Altair-Raphael/SomLetrando/Slides_SomLetrando.pdf

Apresentado por T2BB8 | 2026

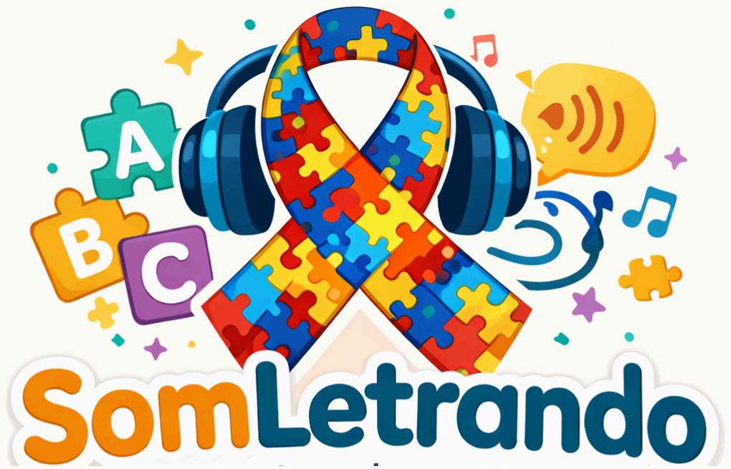
[picture p1: figure]

01

SomLetrando: mais que uma alfabetização através dos sons, um convite lúdico ao multissensorial

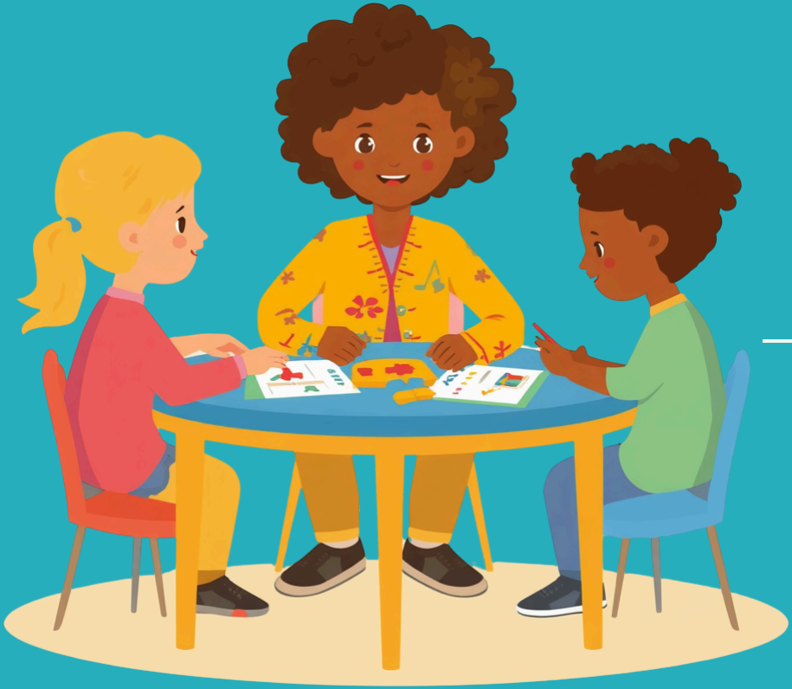
[picture p2: figure]

# Entendendo o Autismo e a Consciência Fonológica

O Transtorno do Espectro Autista (TEA) apresenta desafios únicos no processo de aprendizagem, especialmente na comunicação e linguagem.
A consciência fonológica — capacidade de associar o símbolo de cada letra ao seu respectivo som — é fundamental para o desenvolvimento da leitura e escrita. Crianças com autismo frequentemente apresentam dificuldades nessa área. Desenvolver a consciência fonológica de forma lúdica e adaptada pode transformar a comunicação dessas crianças, abrindo portas para maior autonomia e interação social.

02

## Contexto e Importância

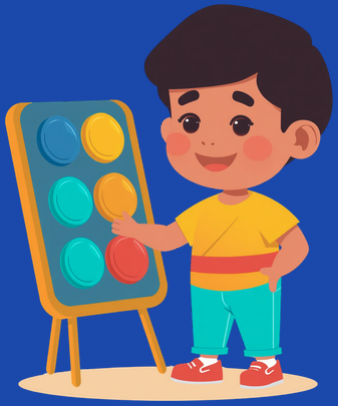
[picture p3: figure]

03

# Objetivo do SomLetrando

Desenvolver a habilidade de soletrar palavras através do reconhecimento do som de cada letra, fortalecendo a consciência fonológica.

Trabalhar a associação entre sons e letras de forma interativa, ajudando a criança a compreender a relação grafema-fonema.

Proporcionar envolvimento lúdico e educativo que motiva a criança a aprender de forma divertida e engajadora.

## Soletração Sonora

## Associação Som-Letra

## Aprendizado Lúdico

Projeto voltado a auxiliar o processo de alfabetização de crianças ( até 12 anos) no espectro autista

## Público alvo

4

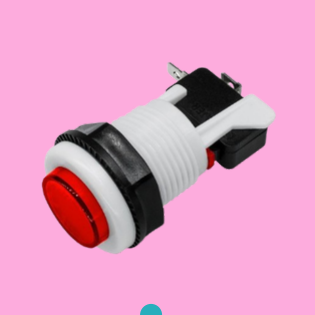
[picture p4: figure]

01

Armazenam letras
aleatórias e a letra
esperada para cada
rodada do jogo.

### 7 Botões Grandes

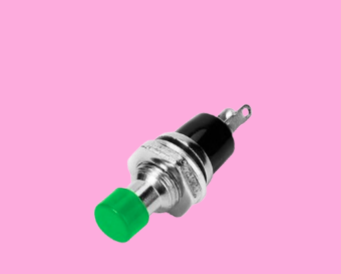
[picture p5: figure]

02

Permite múltplos
testes dos botões
até a confirmação
da jogada

### 1 Botão de Confirmação

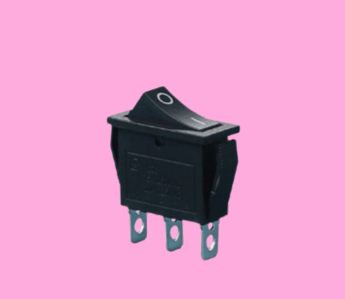
[picture p6: figure]

04

Seleção de modo
de jogo, reset do
sistema e iniciar
nova partida.

### 3 Chaves de Controle

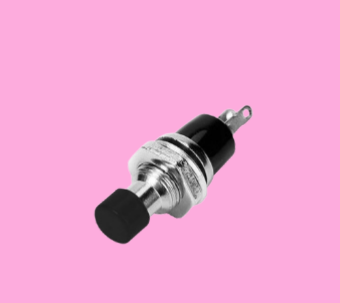
[picture p7: figure]

03

Oferece suporte e
dicas durante o
jogo para auxiliar
a criança.

### 1 Botão de Ajuda

# Visão geral do painel

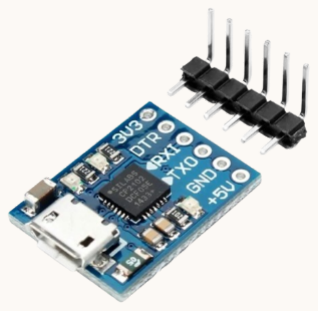
[picture p8: figure]
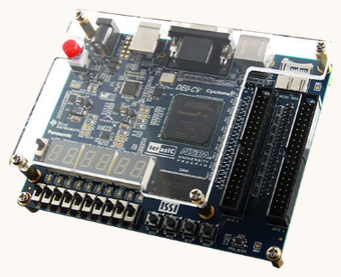
[picture p9: figure]

05

# Tecnologia FPGA e Comunicação UART

A placa FPGA é responsável pelo desenvolvimento do hardware do projeto, permitindo a programação em Verilog dos circuitos lógicos que controlam o painel didático.

## Placa FPGA

O módulo CP2102 permite a troca de dados entre os componentes do sistema, garantindo sincronização entre o painel e a interface gráfica.

## Comunicação UART

06

# Interface Gráfica e Experiência do Usuário

# Design intuitivo e engajamento

Interface completa com projetada especialmente para crianças com autismo. Ex: trocar o modo de jogo, troca a cor da tela

## Interface Intuitiva

Sistema de pontuação de erros semelhante a vidas em videogames, ajudando a criança a entender e corrigir suas respostas de forma construtiva.

## Feedback Visual

Banco com mais de 35 palavras de tamanhos variados garantindo uma experiência diferente para cada jogada

## Aleatoriedade

Experiência tátil (botões personalizados), sonora (letras e palavras em áudio) e visual (painel e interface gráfica)

## Multissensorialidade

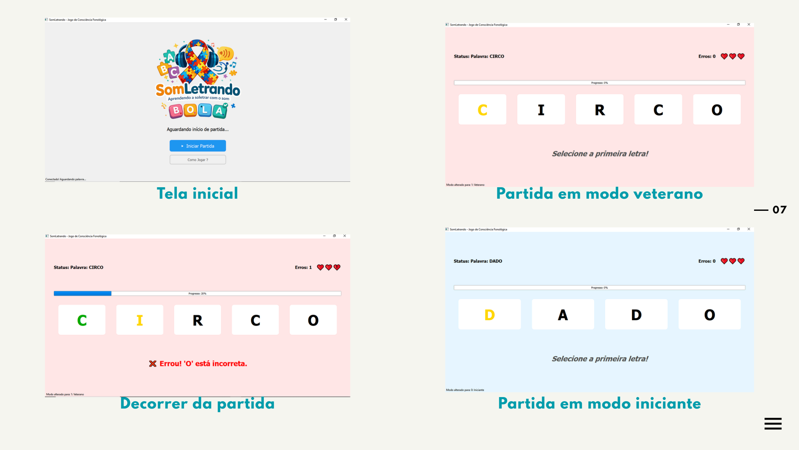
[picture p10: page 7]

Tela inicial | Partida em modo veterano
Decorrer da partida | Partida em modo iniciante

07

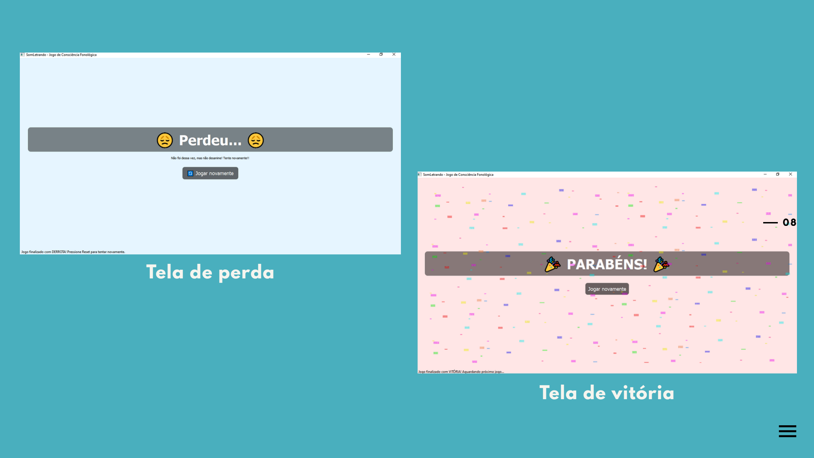
[picture p11: page 8]

# Tela de perda

# Tela de vitória

08

09

# Benefícios para Crianças com Autismo

Estimula o reconhecimento de sons e letras de forma gradual, fortalecendo habilidades
essenciais para leitura e
comunicação.

Botões grandes e coloridos facilitam a interação,
proporcionando autonomia e confiança durante o uso do jogo.

Sons de vitória e indicadores visuais reforçam acertos, enquanto o botão de ajuda oferece suporte imediato quando necessário.

Consciência Fonológica | Acessibilidade | Feedback e Suporte

10

Nome: Enzo Pimentel Lorenzon | Número USP: 14568409
Nome: Altair Raphael Alcazar Perez | Número USP: 14555666
Nome: Giovana Une Oyakawa | Número USP: 15455343

# Obrigado pela atenção!
