Altair-Raphael/SomLetrando/semana_0.2/Semana0.2_T2BB8_Relato.pdf

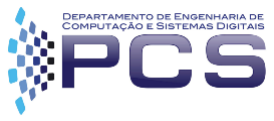
[picture p12: figure]

ESCOLA POLITÉCNICA DA UNIVERSIDADE DE SÃO PAULO Departamento de Engenharia de Computação e Sistemas Digitais

## PCS3635 – LABORATÓRIO DE PROJETO DE SISTEMAS DIGITAIS I

## Semana 0.2 – Pesquisa Refinada de Justificativa do Projeto

### Relato da Bancada B8 – Turma 2 – Prof. Antonio

Data de Emissão: 09 de março DE 2026.

Nome: Enzo Pimentel Lorenzon | Número USP: 14568409
Nome: Giovana Une Oyakawa | Número USP: 15455343

### 1 INTRODUÇÃO

O objetivo deste relatório é documentar os resultados da atividade de pesquisa refinada de justificativa do projeto extensionista de PCS3635 – Laboratório de Projeto de Sistemas Digitais I.

### 2 RELATO DA PESQUISA BIBLIOGRÁFICA

O relato da pesquisa refinada de justificativa do projeto extensionista de PCS3635 está presente na Tabela 1.

Tabela 1 – Relato da Atividade Extensionista
Relato da Atividade e de seus Resultados

Historicamente, apenas cerca de 50% de pessoas no espectro TEA alcançam um nível de domínio de linguagem suficiente para interagir com o meio externo com menores impactos negativos, os outros 50%, não adquirindo essa habilidade, não raramente acabam recorrendo a métodos não convencionais de comunicação (Ex.: autoflagelação, destruição de propriedade, agressividade no geral, etc.). [1].

Para mitigar, esses efeitos negativos, e melhorar a qualidade de vida tanto dos indivíduos no espectro, quanto das pessoas no seu entorno, é utilizada a abordagem fonológica durante a alfabetização. Na verdade, essa é uma metodologia de ensino eficiente tanto para neurotípicos, quanto atípicos[2]. Entretanto, para abranger, também, alunos não verbais, é necessário o uso de uma abordagem conhecida como Nonverbal Reading Approach (NRA)[3]. Ela, com o auxílio de sight words[4], permite que seja utilizada a voz interna do indivíduo (a mesma que ocorre ao ler textos em silêncio) ao invés de verbalizar as palavras oralmente.

Tendo isso em mente, o projeto desenvolvido na disciplina busca abordar de forma lúdica, a partir de um jogo, o desenvolvimento da consciência fonológica tendo em mente atender todos os níveis de suporte do espectro. Para isso, o equipamento terá uma tela para visualização das palavras por escrito, autofalantes para “falar” a palavra escolhida e as letras individualmente, além de botões coloridos correspondentes a cada letra para que o usuário consiga fazer sua jogada.

O espectro TEA abarca 3 níveis de suporte: nível 1 (autismo leve), nível 2 (autismo moderado) e o nível 3 (autismo severo). Em relação ao ensino, o primeiro nível possui maior facilidade de aprendizado quando há inclusão de reforços visuais, já o segundo nível tem maiores dificuldades de comunicação tanto verbal quanto não verbal, por último o terceiro nível demanda uma maior dedicação nas ferramentas de aprendizagem como uso de comunicação alternativa e sistemas multissensoriais.

O especialista no campo de neuroaprendizagem, Grandin (2021) reforça essas características de aprendizado: para crianças com TEA, a previsibilidade, a rotina e os estímulos sensoriais adequados são elementos fundamentais para a consolidação da aprendizagem na medida em que essas características reduzem a ansiedade e aumentam o foco.

Nesse sentido, o projeto se encontra bem definido, integrando múltiplos recursos sensoriais visuais (interfaces gráficas, leds), sonoros (alto falante reproduzindo letras) e táteis (personalização de textura dos botões) e estimulando a aprendizagem de todos os níveis do espectro TEA.

Contudo, vale ressaltar que o aprendizado de autistas, mesmo aqueles que pertencem a um mesmo nível, é completamente distinto entre si. Por conta disso, a mediação social através do professor, algum profissional ou pais é extremamente relevante para facilitar a decodificação simbólica e a formação de memórias linguísticas duradouras.

Assim, o projeto constitui-se como um objeto relevante até mesmo como ferramenta de uso em sala de aula pelos educadores ou em casa pelos pais, não só mediando o aprendizado como também construindo a confiança da criança e fortalecendo vínculos emocionais.

Lista de Referências (se aplicável; caso contrário, marcar como “Não Aplicável”)
1) LAZ, L. ScholarWorks Teaching Emergent Literacy Skills to Students with Autism. [s.l:
s.n.]. | Disponível | em:
<https://scholarworks.boisestate.edu/cgi/viewcontent.cgi?article=1003&context=sped_grad proj>.
2) NUNES, D. R. DE P.; WALTER, E. C. Processos de Leitura em Educandos com Autismo: um Estudo de Revisão. Revista Brasileira de Educação Especial, v. 22, n. 4, p. 619–632, dez. 2016.
3) Nonverbal | Reading. | Disponível | em:
<https://www.eiltsfamily.org/udl_at/resources/Reading/Nonverbal_reading.pdf>. | Assesso
em: 09 mar. 2026.
4) Spector, J.E. Sight Word Instruction for Students with Autism: An Evaluation of the
Evidence | Base. | J | Autism | Dev | Disord | 41, | 1411–1422 | (2011).
https://doi.org/10.1007/s10803-010-1165-x
5) Vista do NEUROAPRENDIZAGEM E ALFABETIZAÇÃO DE CRIANÇAS COM TRANSTORNO DO ESPECTRO DO AUTISMO: COMO ENSINAR AOS NÍVEIS 1, 2 E 3 DE SUPORTE NO 1o ANO DO ENSINO FUNDAMENTAL. Disponível em: <https://realizeducscientificjournal.com/index.php/rsj/pt_BR/article/view/5/4>. Acesso em: 9 mar. 2026.
6) CUGNASCA, P.S.; SILVA NETO, A.V.; MIDORIKAWA, E.T.; ARAKAKI, R.A. O Papel do Laboratório de Eletrônica Digital como Disciplina Integradora de Competências para o Desenvolvimento de Projetos de Engenharia. In: 52º Congresso Brasileiro de Educação em Engenharia (COBENGE 2024). Anais [...]. Vitória (ES), Brasil, 2024. DOI: 10.37702/2175-957X.COBENGE.2024.5074.
7) GitHub: Let’s Build from Here. 2024. Disponível em: <https://github.com/>. Acesso em: 06 fev. 2025.

### 3 AUTOAVALIAÇÃO CIRCUNSTANCIADA DA EQUIPE

A autoavaliação dos membros da pesquisa refinada de justificativa do projeto extensionista de PCS3635 é apresentada entre a Tabela 2 e a Tabela 4.

Tabela 2 – Autoavaliação Circunstanciada do Integrante 1
Nome: | Giovana Une Oyakawa
Número USP: | 15455343
Horas Trabalhadas: | 4h
Autoavaliação (0,0 a 10,0): | 8

Contribuição para a
Equipe e Justificativa (até 300 caracteres):

Houve a dedicação do tempo parcialmente para a pesquisa do público alvo e parcialmente para a pesquisa de desafios. Ao final, uma pesquisa conjunta do grupo foi feita para atualização dos componentes necessários.

Tabela 3 – Autoavaliação Circunstanciada do Integrante BBBBB
Nome: | Enzo Pimentel Lorenzon
Número USP: | 14568409
Horas Trabalhadas: | 4h
Autoavaliação (0,0 a 10,0): | 9
Contribuição para a Equipe e Justificativa (até 300 caracteres): | Trabalho de pesquisa para validar o problema a ser resolvido, bem como quais as metodologias mais adequadas para fornecer uma solução ao público alvo do projeto desenvolvido na disciplina.
