Altair-Raphael/SomLetrando/semana1/docs/PCS3635-T2BB8-Planejamento-Semana1.pdf

ESCOLA POLITÉCNICA DA UNIVERSIDADE DE SÃO PAULO Departamento de Engenharia de Computação e Sistemas Digitais

## PCS3635 – LABORATÓRIO DE PROJETO DE SISTEMAS DIGITAIS I

## PROJETO SomLetrando – AEX4

### Especificação Final da Bancada B8 – Turma 2 – Prof. Antonio Vieira

Data de Emissão: 13 de março de 2026.

Nome: Enzo Pimentel Lorenzon | Número USP: 14568409
Nome: Altair Raphael Alcazar Perez | Número USP: 14555666
Nome: Giovana Une Oyakawa | Número USP: 15455343

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
2.4.1

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
2.4.2

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
2.4.3

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
O 10
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
### 1 INTRODUÇÃO

Como tema de projeto da disciplina PCS3635 - Laboratório de Projetos de Sistemas Digitais, foi proposto a criação de soluções voltadas para a comunidade TEA (Transtorno do Espectro Autista). Inicialmente foram feitos trabalhos de pesquisa para entender melhor os desafios enfrentados e as necessidades do público-alvo. Com isso, foi possível definir escopo para o projeto: Auxílio na criação de consciência fonológico de indivíduos no espectro. Historicamente, apenas cerca de 50% de pessoas no espectro TEA alcançam um nível de domínio de linguagem suficiente para interagir com o meio externo com menores impactos negativos, os outros 50%, não adquirindo essa habilidade, não raramente acabam recorrendo a métodos não convencionais de comunicação (Ex.: autoflagelação, destruição de propriedade, agressividade no geral, etc.) [1].

Para mitigar esses efeitos negativos, e melhorar a qualidade de vida tanto dos indivíduos no espectro, quanto das pessoas no seu entorno, é utilizada a abordagem fonológica durante a alfabetização. Na verdade, essa é uma metodologia de ensino eficiente tanto para neurotípicos, quanto atípicos[2]. Entretanto, para abranger, também, alunos não verbais, é necessário o uso de uma abordagem conhecida como Nonverbal Reading Approach (NRA)[3]. Ela, com o auxílio de sight words[4], permite que seja utilizada a voz interna do indivíduo (a mesma que ocorre ao ler textos em silêncio) ao invés de verbalizar as palavras oralmente.

Tendo isso em mente, será desenvolvido um jogo de nome comercial somLetrando, com o objetivo de ensinar e praticar a associação de sons com letras para formar palavras de maneira lúdica, auxiliando no desenvolvimento da consciência fonológica. Um alto-falante externo será responsável por reproduzir o som de uma palavra qualquer contida na memória do circuito e o usuário terá à disposição um painel contendo botões de diversas cores, cada uma associada ao som de uma letra. Com isso, vence o jogo se o jogador for capaz de selecionar na ordem correta as letras que compõem a palavra escolhida a partir de seus sons.

### 2 ESPECIFICAÇÃO TÉCNICA DO PROJETO

O objetivo desta seção do documento é detalhar a especificação técnica do projeto SomLetrando.

### 2.1 CONTEXTO DE APLICAÇÃO DO PROJETO

O espectro TEA abarca 3 níveis de suporte: nível 1 (autismo leve), nível 2 (autismo moderado) e o nível 3 (autismo severo). Em relação ao ensino, o primeiro nível possui maior facilidade de aprendizado quando há inclusão de reforços visuais, já o segundo nível tem maiores dificuldades de comunicação tanto verbal quanto não verbal, por último o terceiro nível demanda uma maior dedicação nas ferramentas de aprendizagem como uso de comunicação alternativa e sistemas multissensoriais.

Para crianças com TEA, a previsibilidade, a rotina e os estímulos sensoriais adequados são elementos fundamentais para a consolidação da aprendizagem na medida em que essas características reduzem a ansiedade e aumentam o foco [5].

Nesse sentido, o projeto se encontra bem definido, integrando múltiplos recursos sensoriais visuais (interfaces gráficas, leds), sonoros (alto falante reproduzindo letras) e táteis (personalização de textura dos botões) e estimulando a aprendizagem de todos os níveis do espectro TEA, contidos na faixa etária de 2 a 12 anos. Esse grupo foi escolhido por existir uma gama de estudos voltadas a esse público mais extensa, infelizmente, o impacto que tais medidas podem ter na educação de pessoas mais velhas ainda não foi estudado com o mesmo empenho. Portanto, é possível ter maior confiabilidade do impacto dos métodos utilizados nesse projeto para o público infantil. Entretanto, nada garante que, com o acompanhamento adequado de profissionais, esse jogo não possa trazer um aumento da qualidade de vida de pessoas fora da faixa etária alvo.

Contudo, vale ressaltar que o aprendizado de autistas, mesmo aqueles que pertencem a um mesmo nível, é completamente distinto entre si. Por conta disso, a mediação social através do professor, algum profissional ou pais é extremamente relevante para facilitar a decodificação simbólica e a formação de memórias linguísticas duradouras.

Assim, o projeto constitui-se como um objeto relevante até mesmo como ferramenta de uso em sala de aula pelos educadores ou em casa pelos pais, não só mediando o aprendizado como também construindo a confiança da criança e fortalecendo vínculos emocionais.

### 2.2 OBJETIVOS DO PROJETO

Dado o contexto de aplicação do projeto para pessoas com TEA, os objetivos podem ser resumidos em:

- Auxiliar o desenvolvimento da comunicação das crianças com TEA, por meio da criação da consciência fonológica;
- Configurar adequadamente os 3 componentes principais do projeto: Placa FPGA, painel de botões e computador externo;
- Criar uma interface de usuário interativa, intuitiva e confortável, para que o foco seja única e exclusivamente o aprendizado dos fonemas e não as regras do jogo. Essa interface será dependente de um computador externo;
- Captar a atenção do público-alvo;
- Desenvolver um banco de palavras para o jogo;

Para atingir estes objetivos de forma eficaz, o projeto fará uso de recursos técnicos específicos, pensados para mitigar as barreiras de aprendizagem:
Configurar adequadamente os 3 componentes principais do projeto: Placa FPGA, painel de botões e computador externo;
- A substituição de teclados convencionais por botões do tipo arcade, criando um painel tangível, reduzirá a sobrecarga motora e sensorial. Isso possibilitará captar a atenção de crianças com desafios de motricidade fina.
- O processamento central na placa DE0-CV garantirá o controle do tempo entre cliques, recurso que é muito importante para evitar que toques acidentais registrem entradas duplicadas.
- Através da comunicação serial, o computador externo reproduzirá os fonemas armazenados no banco de palavras. Tal reprodução deve ter sincronia de forma que prenda a atenção do usuário.

Com esses objetivos e métodos, espera-se que o jogo desenvolvido seja de interesse não apenas para a disciplina e o desenvolvimento da ciência na Universidade, como também cumpra o caráter de atividade extensionista auxiliando na melhor integração de pessoas com o espectro TEA na sociedade.

### 2.3 DESCRIÇÃO DE RECURSOS E CUSTOS

a) Custos e Recursos

Os custos planejados inicialmente envolvidos no projeto estão resumidos na tabela abaixo. Essa tabela poderá variar conforme a evolução do projeto e necessidades verificadas pelo grupo.

Tabela 1 – Lista de Materiais e Custo do Projeto
Item | Quantidade | Custo Unitário | Custo Total | Referência
Placa FPGA DE0-CV | 1 | 0 | 0 | Usada do laboratório
Botão para Fliperama Arcade Push Button PBS-29 | 10 | 7,70 | 77,00 | Saravati (https://www.saravati.com.br/botao-para-fliperama-arcade-push-button-pbs-29-cor-azul.html)
Chave Gangorra Redonda KCD1-106N | 3 | 3,20 | 9,60 | Saravati (https://www.saravati.com.br/chave-gangorra-redonda-kcd1-106n-neon-azul.html)
Leds | 2 | 1,00 | 2,00 | Saravati (https://www.saravati.com.br/led-5mm-alto-brilho-bicolor-vermelho-verde.html)
Computador pessoal | 1 | 0 | 0 | Alunos
Impressão do manual de usuário (3pág cada) | 3 | 2,00/pág | 20,00 | Copiadoras
Caixa organizadora | 1 | 17,90 | 17,90 | Saravati (https://www.saravati.com.br/caixa-organizadora-pequena-n118.html)
1 kit de 40 jumpers | 1 | 7,50 | 7,50 | Robocore (https://www.robocore.net/cabo/jumpers-macho-femea-x40-unidades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)

Item | Quantidade | Custo Unitário | Custo Total | Referência
Filamento de Impressão (protótipo caixa) | 1 | 37,48 | 37,48 | 3D Lab (https://3dlab.com.br/produto/filamento-abs-premium-verde-agua/?attribute_pa_peso=500g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)
Retalhos com texturas diversas | 8 | 5,00 | 40,00 | Lojas físicas (brás, 25, etc)
Custo Total do Projeto: | | | 211,48

Após pesquisa da semana 0.2 e a conversa com o Monitor Gabriel, foram adicionados para essa especificação completa: retalhos de tecidos com texturas que irão ser colocadas por cima dos botões para auxiliar no desenvolvimento tátil dos autistas uma margem de 10% na quantidade de componentes comprados visando prever quaisquer tipos de falhas ou erros de execução do projeto. Além disso, com a implementação de dois modos de jogo, foi adicionada mais uma chave ao projeto, além de um LED que sinaliza vitória para estimular a sinalização positiva.

b) Quantidade de horas de trabalho semanais planejadas pela equipe

Para o desenvolvimento adequado do projeto dentro do tempo estipulado, o grupo pretende dedicar, além do tempo de aula, um total de 5h para cada integrante, distribuídas ao longo da semana. Sabe-se que períodos com maior necessidade de desenvolvimento, tais como a semana 4 e 5 (openlab), exigirão uma carga horária de dedicação maior caso ocorram complicações durante a elaboração do projeto.

### 2.4 DEFINIÇÃO DA ARQUITETURA DO SISTEMA

Nesta seção, são apresentadas as descrições estrutural e comportamental do sistema correspondente ao projeto SomLetrando. Essa descrição é dividida em três partes: (i.) comportamental, com a dinâmica de funcionamento do sistema, (ii.) storytelling das interações dos usuários com o sistema e (iii.) estrutural, com a identificação dos blocos funcionais e de suas partes.

### 2.4.1 Descrição da Arquitetura Comportamental


Figura 1: Fluxograma da execução do projeto
Inicialmente, o usuário deve iniciar o dispositivo e depois escolher uma palavra do banco com o modo de jogo (fácil ou difícil). Caso o usuário opte pelo modo fácil, o projeto irá reproduzir a primeira letra da palavra em áudio e permitirá o teste dos botões para que o jogador encontre o botão que presume ser o correspondente ao som que ouviu até que aperte o botão confirma. Caso acerte, o projeto faz com que o usuário tente acertar a primeira letra novamente e depois acerte a segunda letra e assim sucessivamente até completar a palavra. No caso do modo difícil, o usuário ouve a palavra por completo e depois deverá soletrar a palavra por completo, acertando os botões em sequência, mas ainda podendo utilizar os botões de confirmar a escolha e repetir a palavra. Nos dois modos, caso o jogador erre alguma letra em qualquer momento, o projeto vai para um estado de erro e reproduz em tela: “Boa tentativa, não desanime e tente novamente” e reproduz um som de perda. O usuário pode apertar o botão para repetição da letra (modo fácil) ou palavra (modo difícil) a qualquer momento e pode testar múltiplas vezes os sons das letras guardadas nos botões. Ao finalizar o modo de jogo corretamente, o jogo imprime em tela uma frase “Uhul!! Você acertou, vamos jogar mais?”, além de acender um led verde de vitória no painel de botões e reproduzir a frase em alto falante.

### 2.4.2 Storytelling da Interação entre Usuários e Sistema

O usuário principal, uma criança com TEA, senta-se diante de uma caixa com botões coloridos e uma tela à sua frente. O computador emite o som da palavra “MESA”, e a criança aperta os botões coloridos relacionados aos sons “M”, “E”, “S”, “A”, nesta ordem. A cada acerto, o sistema encoraja a continuação, até emitir uma mensagem final de vitória. No caso de erro, uma mensagem de “Tente Novamente” é exibida. Além dos botões sonoros, duas alavancas, uma para iniciar o jogo, e outra para o nível de dificuldade podem ser selecionadas pelo usuário. Por fim, dois botões auxiliares de repetir escolha e de confirmar escolha se encontram na caixa.


Figura 2: Interação entre criança e SomLetrando

### 2.4.3 Descrição da Arquitetura Estrutural

O sistema seguirá uma arquitetura simplista: Entrada de dados do usuário será feita através de botões externos conectados a placa FPGA-DE0CV, ela será responsável por receber os sinais vindos do painel de botões, ler o conteúdo da memória e retransmitir os dados para o computador externo, que os processa e replica os áudios necessários.

Tabela 2 – Descrição das Interfaces entre Blocos do Sistema
Código | Descrição da Interface
A | Painel com botões coloridos
B | Placa FPGA
C | Software do Computador
D | Interface gráfica para o usuário a ser exibida no computador


Figura 3: Diagrama de blocos - visão geral


Figura 4: Diagrama do painel de botões (A)
Nesse diagrama, os botões foram coloridos para representação de que possuem texturas distintas. Como o projeto possuirá 7 letras aleatórias a cada jogada, cada uma associada a um botão, então os botões foram nomeados de 1 a 7 (Figura 3). Além disso, também foram representados uma chave para iniciar o jogo, LED's que indicam acerto e erro do usuário, um botão auxiliar caso o usuário deseje, quantas vezes quiser, repetir a palavra objetivo e, por fim, um botão que confirma a escolha do botão com base no último botão apertado.

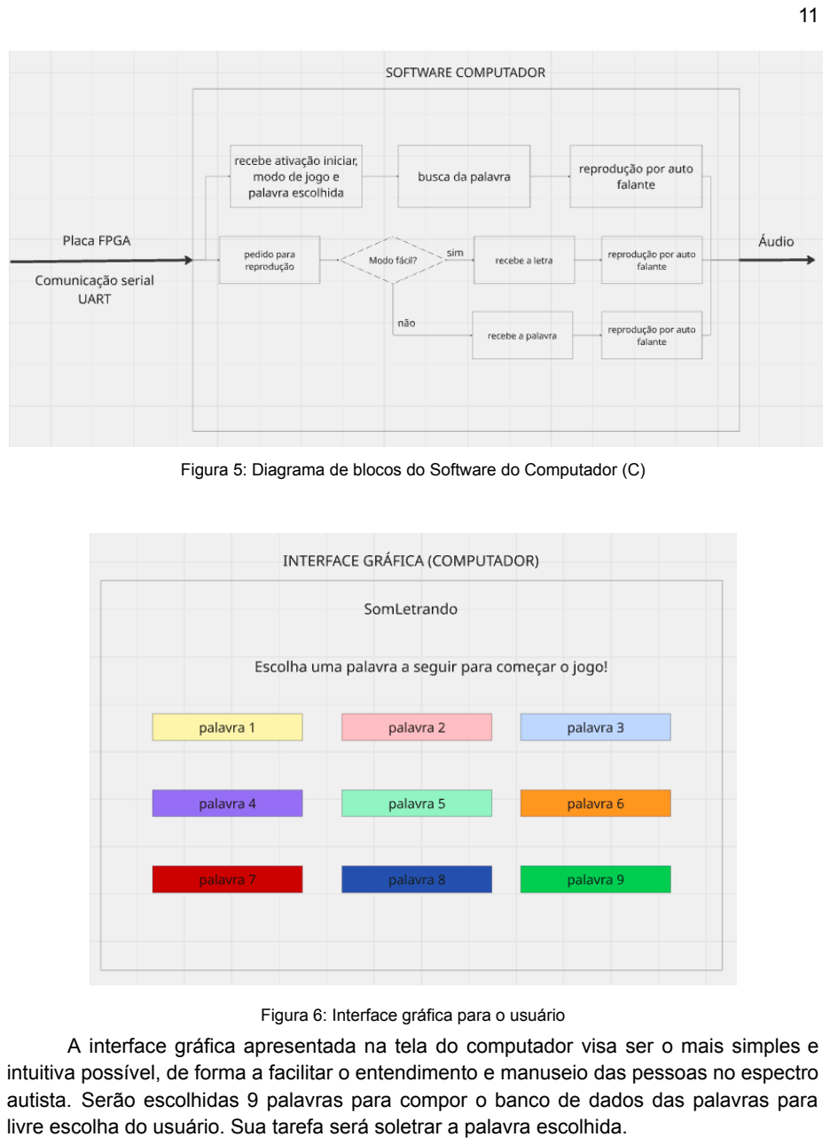
[picture p54: page 11]

Figura 5: Diagrama de blocos do Software do Computador (C)

Figura 6: Interface gráfica para o usuário
A interface gráfica apresentada na tela do computador visa ser o mais simples e intuitiva possível, de forma a facilitar o entendimento e manuseio das pessoas no espectro autista. Serão escolhidas 9 palavras para compor o banco de dados das palavras para livre escolha do usuário. Sua tarefa será soletrar a palavra escolhida.

### 2.5 ESPECIFICAÇÃO DE REQUISITOS

Nesta seção, são apresentados os requisitos funcionais e não funcionais do projeto SomLetrando. Os requisitos são especificados com base na abordagem proposta em [1], que prevê que cada requisito compreende as seguintes informações:

- Código de identificação;
- Tipo (funcional ou não funcional);
- Título;
- Descrição (com frases assertivas e sujeitos ativos);
- Prioridade;
- Estabilidade;
- Rationale (informações adicionais e justificativas);
- Requisitos associados.

Tabela 3 – Especificação do Requisito REQ-01

Código: REQ-01 | ☒Funcional | ◻ Não Funcional

Requisito: Interface Física de Entrada

Descrição: O sistema deve possuir um painel tangível composto por pelo menos 7 botões do tipo Arcade, onde cada botão será mapeado para um fonema/letra específico.

Prioridade: | ☒ Alta | ◻ Média | ◻ Baixa
Estabilidade: | ☒ Alta | ◻ Média | ◻ Baixa

Rationale: O uso de botões grandes e coloridos melhora a resposta tátil e reduz a sobrecarga sensorial em comparação com o uso de um teclado convencional de computador.

Requisitos associados: REQ-02

Tabela 4 – Especificação do Requisito REQ-02

Código: REQ-02 | ◻Funcional | ☒ Não Funcional

Requisito: Sincronia Audiovisual

Descrição: O Sistema deve garantir a emissão do estímulo sonoro da palavra com uma latência imperceptível .

Prioridade: | ☒ Alta | ◻ Média | ◻Baixa
Estabilidade: | ◻ Alta | ☒ Média | ◻ Baixa

Rationale: Estímulos sincronizados e previsíveis são essenciais para a fluidez do jogo e para evitar gerar frustração ou perda de foco do usuário

Requisitos associados: REQ-01

Tabela 5 – Especificação do Requisito REQ-03

Código: REQ-03 | ☒Funcional | ◻ Não Funcional

Requisito: Feedback Audiovisual de Validação

Descrição: O sistema deve fornecer um feedback claro, imediato e previsível para cada acerto ou erro da criança.

Prioridade: | ☒ Alta | ◻ Média | ◻Baixa
Estabilidade: | ☒ Alta | ◻ Média | ◻ Baixa

Rationale: Crianças com TEA se beneficiam da previsibilidade e de relações claras de causa e efeito. Dessa forma, o feedback imediato reforça o acerto do usuário.

Requisitos associados: REQ-01, REQ-02.

Tabela 6 – Especificação do Requisito REQ-04

Código: REQ-04 | ◻Funcional | ☒ Não Funcional

Requisito: Tolerância a toques acidentais estereotipias

Descrição: O sistema da placa FPGA deve conter uma lógica de debouncing e um tempo de delay mínimo entre leituras sucessivas do mesmo botão, evitando que tremores ou toques múltiplos acidentais registrem a mesma letra/fonema de forma repetida.

Prioridade: | ◻ Alta | ☒ Média | ◻ Baixa
Estabilidade: | ☒ Alta | ◻ Média | ◻ Baixa

Rationale: Crianças com TEA podem apresentar estereotipias motoras, dessa forma o sistema deve ser tolerante a essas características, não penalizando a criança por toques não intencionais.

Requisitos associados: REQ-01

Tabela 7 – Especificação do Requisito REQ-05

Código: REQ-05 | ☒Funcional | ◻ Não Funcional

Requisito: Seletor de dificuldade

Descrição: Permitir que o usuário defina se o sistema deverá reproduzir o som da leitura da palavra ou reproduzir o som de cada letra na sequência adequada

Prioridade: | ◻ Alta | ☒ Média | ◻ Baixa
Estabilidade: | ☒ Alta | ◻ Média | ◻ Baixa

Rationale: Permite que o usuário possa adequar o nível de dificuldade do jogo para corresponder a suas competências.

Requisitos associados: -

Tabela 8 – Especificação do Requisito REQ-06

Código: REQ-06 | ☒Funcional | ◻ Não Funcional

Requisito: Coleta e exibição de métricas de desempenho

Descrição: O sistema deve calcular métricas do desempenho (acertos) do usuário e exibi-las de forma contínua nos displays de 7 segmentos.

Prioridade: | ◻ Alta | ◻ Média | ☒ Baixa
Estabilidade: | ◻ Alta | ☒ Média | ◻ Baixa

Rationale: Coletar métricas do usuário permite que cuidadores ou terapeutas possam avaliar quantitativamente a evolução fonológica da criança.

Requisitos associados: REQ-02, REQ-05

Código: REQ-07 | ☒Funcional | ◻ Não Funcional

Requisito: Aleatorização dos botões correspondentes às letras e da escolha de palavras

Descrição: O sistema deve escolher aleatoriamente a palavra a ser soletrada em cada partida, bem como aleatorizar a atribuição das letras aos botões, ou seja, as letras não terão posições fixas no painel.

Prioridade: | ◻ Alta | ◻ Média | ☒ Baixa
Estabilidade: | ☒ Alta | ◻ Média | ◻ Baixa

Rationale: Aleatorizar o funcionamento do jogo faz com que o usuário não possa buscar “atalhos” por meio de memorização de padrões de repetição e de fato desenvolva a competência fonológica.

Requisitos associados: REQ-01, REQ-02

Código: REQ-08 | ☒Funcional | ◻ Não Funcional

Requisito: Configuração da placa FPGA

Descrição: O sistema deve ser capaz de escolher e ler o conteúdo de memória, além responder a sinais entrados por meio de botões na própria placa (Iniciar e Reset).

Prioridade: | ☒ Alta | ◻ Média | ◻ Baixa
Estabilidade: | ☒ Alta | ◻ Média | ◻ Baixa

Rationale: A placa FPGA será a fundação de todo esse sistema, ela será responsável por interpretar os sinais entrados pelo usuário, bem como enviá-los para o computador, que servirá como interface de áudio.

Requisitos associados: -

### 2.6 CRONOGRAMA DO PROJETO

O cronograma do projeto SOMLETRANDO é apresentado na Tabela 4. Nele, cada um dos requisitos especificados na seção 2.5 está alocado aos marcos das semanas de desenvolvimento do projeto. A presença de um “X” em uma célula da tabela indica que o requisito cujo código de identificação foi definido na seção 2.5 é previsto para ser implementado e demonstrado na(s) respectiva(s) semana(s) de desenvolvimento.

Tabela 4 – Cronograma do Projeto

Requisito | Semana 1 | Semana 2 | Semana 3 | Semana 4
Configuração inicial da FPGA e UART | X
Leitura de memória e sinais de | | X

Requisito | Semana 1 | Semana 2 | Semana 3 | Semana 4
controle da FPGA
Montagem estrutural do painel físico | | | X
Integração do painel com FPGA e testes para duplo clique | | | X | X
Sincronia Audiovisual e Comunicação da FPGA com o PC | | X | X
Lógica da Máquina de Estados | | X | X
Integração, testes validação dos níveis | | | | X
Lógica do feedback e aleatorização | | | X | X
Coleta e exibição de métricas nos displays | | | X | X
Impressão dos manuais do projeto | | | | X
Disponibilidade de materiais e recursos | X | X | X

### 3 SEMANA 1 DO PROJETO

O planejamento dessa semana contempla a configuração inicial da placa FPGA com para prepará-la para a integração com os outros circuitos externos necessários para o desenvolvimento desse projeto. Para isso, será utilizada a linguagem de descrição de hardware Verilog e a ferramenta Intel Quartus Prime. O projeto foca na estruturação do sistema em duas grandes unidades: o Fluxo de Dados, responsável pelo processamento e armazenamento das informações, e a Unidade de Controle, responsável pela coordenação das operações e transições de estados. O circuito será validado no ModelSim e a implementação final será feita na FPGA DE0-CV, permitindo a validação física do circuito através de testes em bancada.

### 3.1 DESCRIÇÃO FUNCIONAL DO PROJETO PARA A SEMANA

O projeto para a semana 1 é uma alteração do circuito já trabalhado na Experiência 5, caminhando para um circuito capaz de ler aleatoriamente uma ROM contendo uma palavra. A palavra será composta por até endereços de 4 bits cada, a serem enviados para decodificação no computador por meio de um protocolo de comunicação ainda não definido pelo grupo. O funcionamento do sistema obedece às seguintes especificações técnicas:

- Interface e Interação: O jogo é iniciado através do sinal jogar. O usuário deve inserir a sequência correta através dos botões (botões), sendo que cada acionamento ocorre obrigatoriamente após pressionar o botão de confirmação de jogada, registrando-a e comparado imediatamente com o conteúdo da memória ROM interna. Qualquer partida pode ser interrompida a partir da ativação do sinal de reset.
- Modos de Operação: O sistema permite a seleção de dois modos distintos: Em um dos modos, a palavra inteira é enviada para o computador externo e é lida por ele de uma vez. Já no outro, as letras que compõem a palavra são enviadas sequencialmente, na ordem correta, toda vez que o usuário acertar a letra anterior.
- Progressão: O jogo não fará, propositalmente a escolha de palavras mais ou menos difíceis, a ideia é que todas sigam uma complexidade uniforme e o tamanho do desafio seja selecionado pelos modos de operação.
- Condições de Derrota: O ciclo é interrompido, ativando o sinal pedido, caso o usuário insira um dado incorreto e aperte o botão de confirmar.
- Feedback e Depuração: Além dos sinais de estado final (ganhou, perdeu, pronto), o projeto inclui sinais de depuração (db_contagem, db_memoria, db_estado) mapeados para displays de sete segmentos, permitindo a visualização em tempo real do estado da Unidade de Controle e do progresso do usuário na sequência.

### 3.2 DETALHAMENTO DO PROJETO LÓGICO DO HARDWARE PROGRAMÁVEL

### 3.2.1 Projeto do Fluxo de Dados

Em relação ao fluxo de dados da experiência 5, foram adicionadas 4 blocos de memória ROM síncronos, um multiplexador 4x1, além do sinal de entrada confirmar, que é conectado diretamente no edge_detector, para garantir que uma nova jogada seja identificada somente por esse sinal, e não mais por qualquer alteração nas chaves de jogada do usuário. Também foi adicionado o sinal de entrada: confirmar.


Figura 1: Fluxo de dados (RTL Viewer)

### 3.2.2 Projeto da Unidade de Controle

Não foram feitas alterações na unidade de controle em relação ao projeto base da experiência 5. Dessa forma, tanto os estados quanto a lógica de transição entre eles continuam as mesmas.

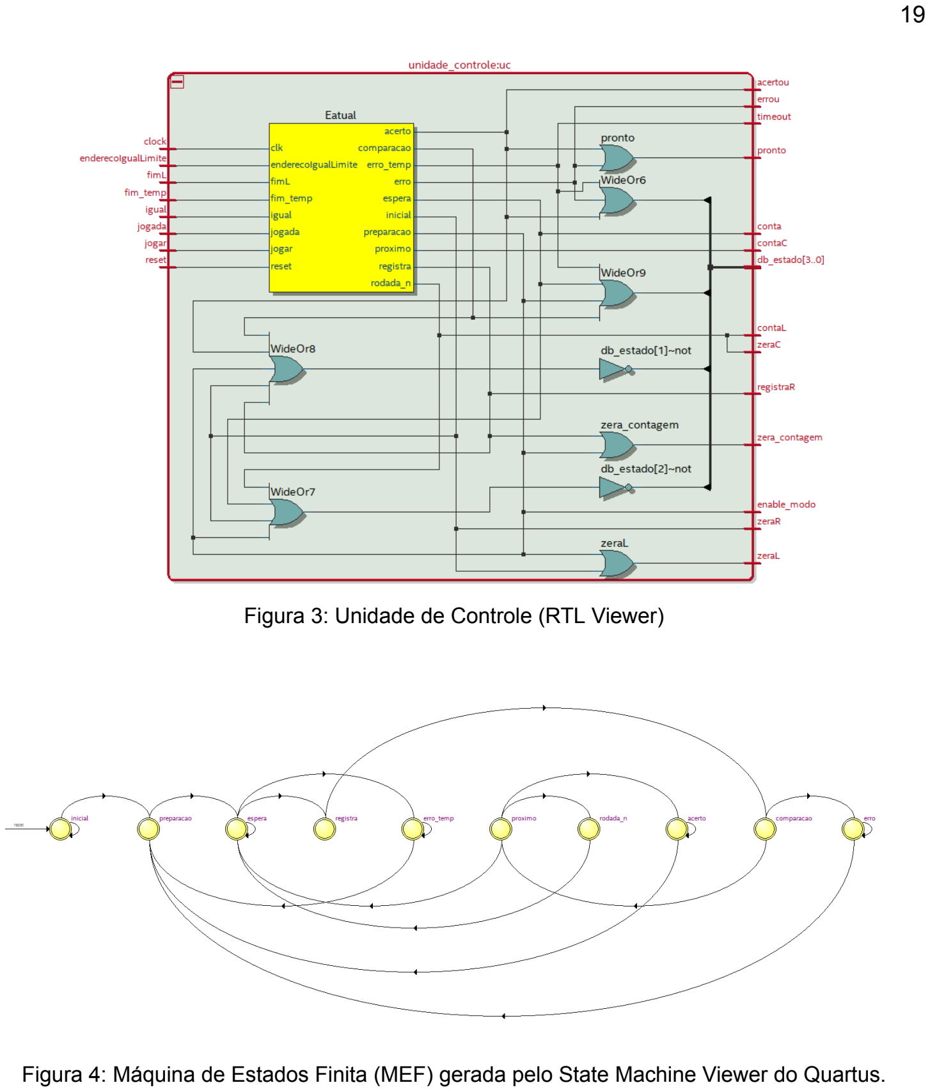
[picture p55: page 19]

Figura 3: Unidade de Controle (RTL Viewer)

Figura 4: Máquina de Estados Finita (MEF) gerada pelo State Machine Viewer do Quartus.

### 3.2.3 Projeto do Sistema Digital Programável

Foi adicionado o sinal externo ¨confirmar¨ que corresponderá ao botão acionado pelo usuário para enviar sua jogada ao registrador.


Figura 6: Diagrama de blocos do top level gerado pelo RTLViewer

### 3.3 PLANO DE TESTES DO HARDWARE PROGRAMÁVEL E SIMULAÇÕES

Como grande parte da experiência 5 foi reaproveitada para esse projeto e o objeto de testes desta semana será a aleatorização do circuito, não faz sentido a criação de testbenches para verificar o funcionamento do circuito, uma vez que isso já foi validado anteriormente. Com isso, serão feitos os testes para mostrar esse comportamento aleatório de seleção da ROM do circuito, bem como o funcionamento do ¨confirmador¨ de jogadas.

### 3.3.1 CENÁRIO DE TESTE 1 – ALEATORIZAÇÃO DE ESCOLHA DA ROM

Caso de teste para demonstrar a escolha aleatória da memória ROM baseada no momento em que o usuário aperta o botão de iniciar.

Tabela 2 – Descrição e Resultados Simulados do Cenário de Teste 1

Test e | Sinais de entrada | Modo | Resultado Esperado | Resultado Observado
reset | iniciar | chaves
C.I | 0 | 0 | 0000 | | - | Ok
1 | 1 | - | - | 1 | - | Ok

2 | 0 | - | - | 1 | - | Ok
3 | - | 1 | - | 1 | saída db_iniciar ativada | Ok
4 | - | 0 | - | - | seletor_rom_out = 11 | Ok
5 | 1 | 0 | - | - | seletor_rom_out = 00 | Ok
6 | - | 1 | - | 1 | saída db_iniciar ativada | Ok
7 | | | | | seletor_rom_out = 10 | Ok


Figura 7: Cursor posicionado indicado mostrando seleção de memória da primeira partida (11) e da segunda (10).

Como é possível observar, essa simulação valida a aleatoriedade da escolha da memória ao início de cada partida. Apenas reforçando, os valores de preenchimento da tabela de testes se referem exclusivamente a essa simulação executada, realizando ela com os mesmos sinais de entrada e na mesma sequência, nada garante que a saída será idêntica a essa.

3.3.2 CENÁRIO DE TESTE 2 - VALIDAÇÃO DO SINAL CONFIRMA AO EXECUTAR JOGADAS

A entrada será alterada por meio das chaves, e após alguns ciclos de clock será ativado o sinal confirmar. Com isso, espera-se que ao final da simulação o sistema tenha registrado a
jogada somente após o sinal de confirmação.
Test e | Sinais de entrada | confirmar | Resultado Esperado | Resultado Observado
reset | iniciar | chaves
C.I | 0 | 0 | 0000 | 0 | - | Ok
1 | 1 | - | - | - | - | Ok
2 | 0 | - | - | - | - | Ok
3 | - | 1 | - | - | saída db_iniciar ativada | Ok
4 | - | 0 | 0010 | - | jogada_reg_out = 0000 | Ok
5 | 1 | 0 | 0000 | - | jogada_reg_out = 0000 | Ok
6 | - | 0 | 0010 | - | jogada_reg_out = 0000 | Ok
7 | - | - | - | 1 | jogada_reg_out = 0010 | Ok


Figura 8: Forma de onda mostrando o registro da jogada somente após o sinal de confirmar

Como mostrado, o sinal de confirmar de fato cumpre com o comportamento especificado no projeto.

3.4 PROTOTIPAÇÃO DE PROJETo
Continua seguindo as mesmas instruções de montagem que as já presentes no planejamento/relato da experiência 5. A única alteração está no pin planner, onde o botão correspondente ao sinal de confirmar foi alocado para o pino PIN_M6.

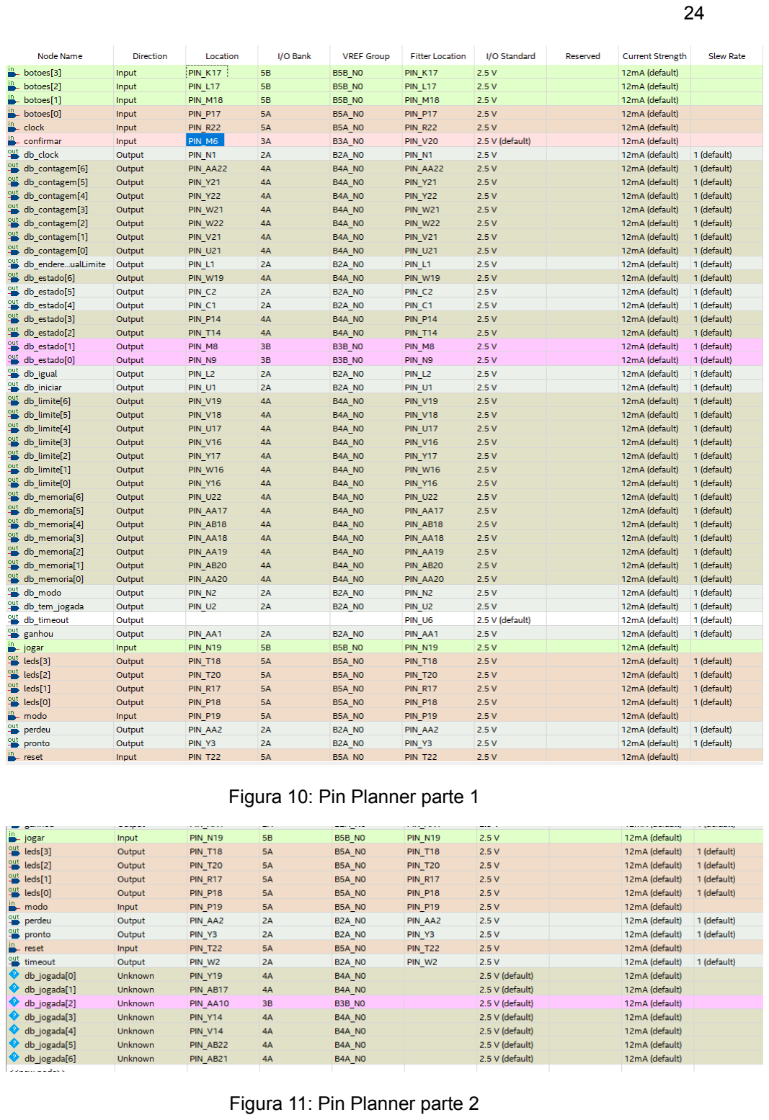
[picture p56: page 24]

Figura 10: Pin Planner parte 1

Figura 11: Pin Planner parte 2

### 4 CONCLUSÕES DO PROJETO

Ao fim das aulas extensionistas (AEX 1 a 4), além das semanas 0.1 e 0.2, foi possível adquirir uma bagagem teórica extremamente importante para identificar problemas e buscar eventuais soluções voltadas à comunidade TEA. Com isso foi definido que o objetivo do projeto desenvolvido nesta disciplina será o auxílio à alfabetização de crianças no espectro autista, uma vez que isso representa um aspecto fundamental na busca desse público por independência e grande melhoria de qualidade de vida.

Durante a elaboração desta especificação final, o principal desafio foi de traduzir necessidades clínicas e pedagógicas, como a previsibilidade, a tolerância ao erro e a adaptação sensorial, em requisitos técnicos rigorosos de engenharia. A adoção de uma arquitetura modular, que divide as responsabilidades do hardware tangível (FPGA e Painel) e da interface audiovisual do software (Computador) demonstrou ser a solução mais robusta para lidar com as características do Transtorno do Espectro Autista.
Como perspetiva de trabalhos futuros e próximos passos para as semanas de OpenLab, iremos iniciar a implementação do cronograma. O desenvolvimento irá se iniciar pela consolidação da comunicação UART entre a FPGA e o computador, avançando progressivamente para a lógica sequencial dos modos de jogo e montagem física do painel. A expectativa é que, com este planejamento delineado, o protótipo do SomLetrando chegue à Feira de Projetos como uma ferramenta assistiva funcional, validada e com elevado potencial de impacto social.

Para a semana 1 o planejamento executado sofreu com graves problemas de gestão de tempo, tendo sua qualidade final sido prejudicada por conta disso. Tais inconsistências e incompletudes serão corrigidas no relato da semana 1.

### 5 REFERÊNCIAS BIBLIOGRÁFICAS

[1] LAZ, L. ScholarWorks Teaching Emergent Literacy Skills to Students with Autism. [s.l: s.n.].
Disponível | | | | | em:
<https://scholarworks.boisestate.edu/cgi/viewcontent.cgi?article=1003&context=sped_gradproj >.
[2] NUNES, D. R. DE P.; WALTER, E. C. Processos de Leitura em Educandos com Autismo: um Estudo de Revisão. Revista Brasileira de Educação Especial, v. 22, n. 4, p. 619–632, dez. 2016.
[3] Nonverbal | | Reading. | Disponível | | em:
<https://www.eiltsfamily.org/udl_at/resources/Reading/Nonverbal_reading.pdf>. Acesso em: 09 mar. 2026.
[4] Spector, J.E. Sight Word Instruction for Students with Autism: An Evaluation of the Evidence Base. J Autism Dev Disord 41, 1411–1422 (2011). https://doi.org/10.1007/s10803-010-1165-x
[5] Vista do NEUROAPRENDIZAGEM E ALFABETIZAÇÃO DE CRIANÇAS COM TRANSTORNO DO ESPECTRO DO AUTISMO: COMO ENSINAR AOS NÍVEIS 1, 2 E 3 DE SUPORTE NO 1o
ANO | DO | ENSINO | FUNDAMENTAL. | Disponível | em:
<https://realizeducscientificjournal.com/index.php/rsj/pt_BR/article/view/5/4>. Acesso em: 9 mar. 2026.
[6]
[7] OBERG, R.; PROBASCO, L.; ERICSSON, M.; Applying Requirements Management with Use Cases. Rational Software Corporation. Technical Paper TP505 (Version 1.4), 2001.
[8] BRITES, L. Métodos de alfabetização: qual o mais adequado às crianças autistas? -
Instituto | NeuroSaber. | Disponível | em:
<https://institutoneurosaber.com.br/artigos/metodos-de-alfabetizacao-qual-o-mais-adequado-criancas-autistas/>.
[9] ALMEIDA, Izabel Cristina Araujo. Alfabetização de alunos com transtorno do espectro autista (TEA) : concepções e práticas dos professores. 2019. 147 f. Dissertação (Mestrado Acadêmico em Educação) - Universidade Estadual de Feira de Santana, Feira de Santana, 2019.
[10] BRITES, L. Consciência Fonológica em Crianças com Autismo - Instituto
NeuroSaber. | | | Disponível | | em:

<https://institutoneurosaber.com.br/artigos/consciencia-fonologica-no-tea/>.

3.1 DESCRIÇÃO FUNCIONAL DO PROJETO PARA A SEMANA (https://docs.google.com/document/d/1Y7dTLVjswokQQUY5VUKACERoD0E-Ydqh/edit#heading=h.tq2sh9ddmc5l)

3.2 DETALHAMENTO DO PROJETO LÓGICO DO HARDWARE PROGRAMÁVEL (https://docs.google.com/document/d/1Y7dTLVjswokQQUY5VUKACERoD0E-Ydqh/edit#heading=h.acydlzslnpj1)

3.2.1 PROJETO DO FLUXO DE DADOS (https://docs.google.com/document/d/1Y7dTLVjswokQQUY5VUKACERoD0E-Ydqh/edit#heading=h.t0n6ie1offel)

3.2.2 PROJETO DA UNIDADE DE CONTROLE (https://docs.google.com/document/d/1Y7dTLVjswokQQUY5VUKACERoD0E-Ydqh/edit#heading=h.8l4njym28dr4)

3.2.3 PROJETO DO SISTEMA DIGITAL PROGRAMÁVEL | 11 (https://docs.google.com/document/d/1Y7dTLVjswokQQUY5VUKACERoD0E-Ydqh/edit#heading=h.6rqmjnyx58eu)
3.3 PLANO DE TESTES DO HARDWARE PROGRAMÁVEL E SIMULAÇÕES | 11 (https://docs.google.com/document/d/1Y7dTLVjswokQQUY5VUKACERoD0E-Ydqh/edit#heading=h.j7ss6yr314t5)
3.4 DETALHAMENTO DO PROJETO DE SOFTWARE | 12 (https://docs.google.com/document/d/1Y7dTLVjswokQQUY5VUKACERoD0E-Ydqh/edit#heading=h.orpzzea0p65m)
3.4.1 DESCRIÇÃO DA ARQUITETURA DE SOFTWARE | 12 (https://docs.google.com/document/d/1Y7dTLVjswokQQUY5VUKACERoD0E-Ydqh/edit#heading=h.ljcytuhu5ket)
3.4.2 DETALHAMENTO DO PROJETO DE SOFTWARE | 12 (https://docs.google.com/document/d/1Y7dTLVjswokQQUY5VUKACERoD0E-Ydqh/edit#heading=h.ja6b128entfz)
3.5 PLANO DE TESTES DO SOFTWARE | 12 (https://docs.google.com/document/d/1Y7dTLVjswokQQUY5VUKACERoD0E-Ydqh/edit#heading=h.4if59tt559wt)
3.5.1 CENÁRIO DE TESTE X – <OBJETIVO SUCINTO DO CENÁRIO> | 12 (https://docs.google.com/document/d/1Y7dTLVjswokQQUY5VUKACERoD0E-Ydqh/edit#heading=h.75dk5f3aob5u)
3.6 INTEGRAÇÃO ENTRE HARDWARE PROGRAMÁVEL E SOFTWARE | 13 (https://docs.google.com/document/d/1Y7dTLVjswokQQUY5VUKACERoD0E-Ydqh/edit#heading=h.h963ql59e5hq)
3.7 PROTOTIPAÇÃO DO PROJETO | 13 (https://docs.google.com/document/d/1Y7dTLVjswokQQUY5VUKACERoD0E-Ydqh/edit#heading=h.3qikcbrj5d56)
3.8 IMPLANTAÇÃO DO PROJETO | 14 (https://docs.google.com/document/d/1Y7dTLVjswokQQUY5VUKACERoD0E-Ydqh/edit#heading=h.wzvezgyjmn7c)
3.8.1 PINAGEM DA PLACA FPGA | 14 (https://docs.google.com/document/d/1Y7dTLVjswokQQUY5VUKACERoD0E-Ydqh/edit#heading=h.kp4j2b99jtca)
3.8.2 ESTRATÉGIA DE MONTAGEM | 14 (https://docs.google.com/document/d/1Y7dTLVjswokQQUY5VUKACERoD0E-Ydqh/edit#heading=h.pug9bokftyjz)
3.8.3 ESTRATÉGIA DE DEPURAÇÃO | 14 (https://docs.google.com/document/d/1Y7dTLVjswokQQUY5VUKACERoD0E-Ydqh/edit#heading=h.e8z4qmt07iz2)
3.8.4 EXECUÇÃO PRÁTICA DO CENÁRIO DE TESTE X – <OBJETIVO SUCINTO DO CENÁRIO> | 15 (https://docs.google.com/document/d/1Y7dTLVjswokQQUY5VUKACERoD0E-Ydqh/edit#heading=h.3lr66zbkox0k)

3.9 CONCLUSÃO DA SEMANA (https://docs.google.com/document/d/1Y7dTLVjswokQQUY5VUKACERoD0E-Ydqh/edit#heading=h.1xnt67tdaqge)
