Altair-Raphael/SomLetrando/Versão Final/hardware/src/control/SomLetrando.v

	module SomLetrando (
		 //Inputs
		 input        clock,
		 input        reset_entrada,
		 input        jogar,
		 input        confirmar,
		 input        ajuda,
		 input        modo,
		 input  [6:0] botoes,
		 //Outputs
		 output       ganhou,
		 output       perdeu,
		 output       pronto,
		 output [6:0] leds,
		 //Outputs seriais
		 output       saida_serial,
		 output       pronto_serial,

		 //Depuracao leds
		 output       db_igual,
		 output       db_clock,
		 output       db_iniciar,
		 output       db_tem_jogada,
		 output       db_modo, 
		 output 		  db_confirmar,
		 //Depuracao displays
		 output [6:0] db_endereco_letra,
		 output [6:0] db_rom_escolhida,
		 output [6:0] db_letra_more,
		 output [6:0] db_letra_less,
		 output [6:0] db_contagem_erros,
		 output [6:0] db_estado,
		 // Depuracao serial
		 output       db_tick_serial,
		 output       db_saida_serial
	);

	//  Wires
		 wire zera_contador_wire;
		 wire zera_registrador_wire;
		 wire zeraSeletor_wire;

		 wire igual_wire;
		 wire registraR_wire;
		 wire jogada_wire;
		 wire fim_palavra_wire;
		 wire limite_erros_wire;
		 wire conta_erro_wire;
		 wire incrementa_endereco_wire;
		 wire load_end_inicial_wire;
		 wire enable_rom_wire;
		 wire enable_modo_wire;
		 wire enable_palavra_wire;
		 wire modo_wire;
		 wire zera_contador_erros_wire;
		 wire evento_reset_serial_wire;
		 wire evento_jogar_serial_wire;
		 wire evento_modo_serial_wire;
		 wire evento_erro_serial_wire;

		 wire start_tx_wire;
		 wire start_tx_ack_wire;
		 wire tx_done_inicial_wire;
		 wire start_tx_aux_req_wire;
		 wire start_tx_aux_ack_wire;
		 wire start_tx_mux_wire;
		 wire start_tx_inicial_req_wire;
		 wire start_tx_aux_req_aceito_wire;
		 wire tx_ready_wire;
		 reg  tx_busy_wire;

		 wire [3:0] estado_wire;
		 wire [3:0] db_endereco_letra_wire;
		 wire [3:0] db_rom_escolhida_wire;
		 wire [6:0] jogadafeita_wire;
		 wire [3:0] db_contagem_erros_wire;

		 wire [6:0] db_letra_wire; //letra em ascii completa a ser enviada serial
		 wire [6:0] tx_data_aux_wire;
		 wire [6:0] tx_data_mux_wire;
		 wire [6:0] jogada_parcial_decodificada_wire;
		 wire [6:0] letra_atual_wire;
		 wire [7:0] palavra_base_wire;
		 wire       evento_jogada_parcial_wire;
		 wire [3:0] db_letra_less_wire; //letra em ascii bits menos significativos para display
		 wire [3:0] db_letra_more_wire; //letra em ascii bits mais significativos para display

		 // Sinais com debounce
		 wire [6:0] botoes_db_wire;
		 wire confirmar_db_wire;
		 wire ajuda_db_wire;
		 wire reset_liberado_pulso_wire;
		 wire reset;

		 // Considerando clock de 50 MHz
		 localparam [19:0] DEBOUNCE_8MS_TICKS = 20'd399_999;
		 localparam [19:0] DEBOUNCE_2MS_TICKS = 20'd99_999;

		 // Debounce dos 7 botoes de fliperama (8 ms)
		 debounce #(.tempo_debounce(DEBOUNCE_8MS_TICKS)) db_botao_0 (.clk(clock), .reset(reset), .entrada(botoes[0]), .saida(botoes_db_wire[0]));
		 debounce #(.tempo_debounce(DEBOUNCE_8MS_TICKS)) db_botao_1 (.clk(clock), .reset(reset), .entrada(botoes[1]), .saida(botoes_db_wire[1]));
		 debounce #(.tempo_debounce(DEBOUNCE_8MS_TICKS)) db_botao_2 (.clk(clock), .reset(reset), .entrada(botoes[2]), .saida(botoes_db_wire[2]));
		 debounce #(.tempo_debounce(DEBOUNCE_8MS_TICKS)) db_botao_3 (.clk(clock), .reset(reset), .entrada(botoes[3]), .saida(botoes_db_wire[3]));
		 debounce #(.tempo_debounce(DEBOUNCE_8MS_TICKS)) db_botao_4 (.clk(clock), .reset(reset), .entrada(botoes[4]), .saida(botoes_db_wire[4]));
		 debounce #(.tempo_debounce(DEBOUNCE_8MS_TICKS)) db_botao_5 (.clk(clock), .reset(reset), .entrada(botoes[5]), .saida(botoes_db_wire[5]));
		 debounce #(.tempo_debounce(DEBOUNCE_8MS_TICKS)) db_botao_6 (.clk(clock), .reset(reset), .entrada(botoes[6]), .saida(botoes_db_wire[6]));
		 debounce #(.tempo_debounce(DEBOUNCE_8MS_TICKS)) db_botao_7 (.clk(clock), .reset(1'b0), .entrada(reset_entrada), .saida(reset));

		 // Debounce dos botoes convencionais (2 ms)
		 debounce #(.tempo_debounce(DEBOUNCE_2MS_TICKS)) db_confirmar_btn (.clk(clock), .reset(reset), .entrada(confirmar), .saida(confirmar_db_wire));
		 debounce #(.tempo_debounce(DEBOUNCE_2MS_TICKS)) db_ajuda     (.clk(clock), .reset(reset), .entrada(ajuda),     .saida(ajuda_db_wire));

		 // Pulso de 1 ciclo na liberacao do reset global.
		 edge_detector detector_liberacao_reset (
		 	 .clock (clock),
		 	 .reset (reset),
		 	 .sinal (~reset),
		 	 .pulso (reset_liberado_pulso_wire)
		 );
		 
		
		 unidade_controle uc (
			  .clock					 (clock),
			  .reset					 (reset),
			  .jogar  				 (jogar),
			  .jogada			    (jogada_wire),
			  .igual				    (igual_wire),
			  .fim_palavra        (fim_palavra_wire),
			  .start_tx           (start_tx_wire),
			  .tx_start_ack       (start_tx_ack_wire),
			  .tx_done            (tx_done_inicial_wire),
			  .limite_erros       (limite_erros_wire),
			  .zeraSeletor			 (zeraSeletor_wire),
			  .enable_rom		    (enable_rom_wire),
			  .modo               (modo_wire),
			  .enable_modo	    	 (enable_modo_wire),
			  .enable_palavra     (enable_palavra_wire),
			  .zera_contador      (zera_contador_wire),
			  .zera_registrador   (zera_registrador_wire),
			  .conta_erro         (conta_erro_wire),
			  .incrementa_endereco(incrementa_endereco_wire),
			  .load_end_inicial   (load_end_inicial_wire),
			  .zera_contador_erros(zera_contador_erros_wire),
			  .registraR		    (registraR_wire),
			  .acertou				 (ganhou),
			  .errou					 (perdeu),
			  .evento_reset_serial(evento_reset_serial_wire),
			  .evento_jogar_serial(evento_jogar_serial_wire),
			  .evento_modo_serial (evento_modo_serial_wire),
			  .evento_erro_serial (evento_erro_serial_wire),
			  .pronto			    (pronto),
			  .db_estado		    (estado_wire)
		 );

		 fluxo_dados  fd(
			  .clock				  			 (clock),
			  .reset             		 (reset),
			  .zera_contador    		    (zera_contador_wire),
			  .zera_registrador  		 (zera_registrador_wire),
			  .registraR		  		    (registraR_wire),
			  .zeraSeletor	    			 (zeraSeletor_wire),
			.enable_rom		  			    (enable_rom_wire),
			  .chaves			    		 (botoes_db_wire),
			  .confirmar		    		 (confirmar_db_wire),
			  .incrementa_endereco		 (incrementa_endereco_wire),
			 .enable_modo	    			 (enable_modo_wire),
			  .enable_palavra      		 (enable_palavra_wire),
			  .modo              		 (modo),
			  .modo_escolhido     		 (modo_wire),
           .zera_contador_erros		 (zera_contador_erros_wire),
		     .load_end_inicial  		 (load_end_inicial_wire),
		     .conta_erro       			 (conta_erro_wire),
			  .igual							 (igual_wire),
			  .fim_palavra       		 (fim_palavra_wire),
			  .limite_erros       			 (limite_erros_wire),
           .jogada_feita	    			 (jogada_wire),
			  .db_tem_jogada	    			 (db_tem_jogada),
		     .db_contagem_erros  			 (db_contagem_erros_wire),
			  .db_letra			   			 (db_letra_wire),
			  .db_endereco_letra				 (db_endereco_letra_wire),
			  .db_rom_escolhida				 (db_rom_escolhida_wire),
			  .db_jogada	    				 (jogadafeita_wire),
			  .evento_jogada_parcial 		 (evento_jogada_parcial_wire),
			  .jogada_parcial_decodificada (jogada_parcial_decodificada_wire),
			.letra_atual						 (letra_atual_wire),
        .palavra_base 					 (palavra_base_wire)
    );

    tx_rotina_auxiliar tx_aux (
        .clock                      (clock),
        .reset                      (reset),
		.ajuda                      (ajuda_db_wire),
        .modo_escolhido             (modo_wire),
        .evento_jogada_parcial      (evento_jogada_parcial_wire),
        .jogada_parcial_decodificada(jogada_parcial_decodificada_wire),
        .letra_atual                (letra_atual_wire),
        .palavra_base               (palavra_base_wire),
        .tx_busy                    (tx_busy_wire),
        .tx_ready                   (tx_ready_wire),
        .tx_aux_start_ack           (start_tx_aux_ack_wire),
        .tx_aux_start_req           (start_tx_aux_req_wire),
			  .evento_reset               (evento_reset_serial_wire || reset_liberado_pulso_wire),
			  .evento_jogar               (evento_jogar_serial_wire),
			  .evento_modo                (evento_modo_serial_wire),
			  .evento_erro                (evento_erro_serial_wire),
        .tx_aux_data                (tx_data_aux_wire)
    );

    // Definicao da prioridade de envio da transmissao serial para o computador externo
	 reg envio_inicial;
	 reg [6:0] tx_data_latched;

	// Prioriza eventos auxiliares (ex.: '*' e modo) para preservar a ordem do
	// frame de inicializacao antes da sequencia de letras da palavra.
	assign start_tx_aux_req_aceito_wire = (!tx_busy_wire && start_tx_aux_req_wire);
	assign start_tx_inicial_req_wire = (!tx_busy_wire && !start_tx_aux_req_wire && start_tx_wire);

	 assign start_tx_ack_wire = start_tx_inicial_req_wire;
    assign start_tx_aux_ack_wire = start_tx_aux_req_aceito_wire;
    assign start_tx_mux_wire = start_tx_inicial_req_wire || start_tx_aux_req_aceito_wire;
	 assign tx_data_mux_wire = tx_data_latched;
	 assign tx_done_inicial_wire = (tx_busy_wire && tx_ready_wire && envio_inicial);

    always @(posedge clock or posedge reset) begin
        if (reset) begin
            tx_busy_wire <= 1'b0;
			envio_inicial <= 1'b0;
			tx_data_latched <= 7'b0000000;
        end 
        
        else begin
			if (start_tx_inicial_req_wire) begin
				tx_busy_wire <= 1'b1;
				envio_inicial <= 1'b1;
				tx_data_latched <= db_letra_wire;
			end else if (start_tx_aux_req_aceito_wire) begin
                tx_busy_wire <= 1'b1;
				envio_inicial <= 1'b0;
				tx_data_latched <= tx_data_aux_wire;
			end else if (tx_busy_wire && tx_ready_wire)
                tx_busy_wire <= 1'b0;
        end
    end

    hexa7seg rom_escolhida ( //0
        .hexa(db_rom_escolhida_wire),
        .display(db_rom_escolhida)
    );

    hexa7seg endereco_letra ( //1
        .hexa(db_endereco_letra_wire),
        .display(db_endereco_letra)
    );

    hexa7seg letraless ( //2
        .hexa(db_letra_less_wire), //mostra os bits menos significativos da letra em ascii
        .display(db_letra_less)
    );

    hexa7seg letramore ( //3
        .hexa(db_letra_more_wire), //mostra os bits mais significativos da letra em ascii
        .display(db_letra_more)
    );

	hexa7seg contagem_erros ( //5
        .hexa(db_contagem_erros_wire),
        .display(db_contagem_erros)
    );
	
    hexa7seg estado ( //6
        .hexa(estado_wire),
        .display(db_estado)
    );

    //transmissao que ocorre logo que o jogador escolhe a palavra pra ouvir pela primeira vez
    tx_serial_7N2 transmissao_FPGA_inicial ( 
        //entradas
        .clock           (clock),
        .reset           (reset),
        .partida         (start_tx_mux_wire),
        .dados_ascii     (tx_data_mux_wire),
        //saidas
        .saida_serial    (saida_serial), 
        .pronto          (tx_ready_wire), //indica que a letra foi transmitida e o sistema pode passar para a proxima letra
        .db_clock        (),
        .db_tick         (db_tick_serial),
        .db_partida      (),
        .db_saida_serial (db_saida_serial),
        .db_estado       () //ja esta em hexa; ser?? 4 display
    );

    assign db_igual = igual_wire;
	assign db_confirmar = jogada_wire;
    assign leds = jogadafeita_wire;
    assign pronto_serial = tx_ready_wire;
    assign db_clock = clock;
    assign db_iniciar = jogar;
    assign db_modo = modo_wire;

    //letras particionamento
    assign db_letra_less_wire = db_letra_wire[3:0];
    assign db_letra_more_wire = {1'b0,db_letra_wire[6:4]};

endmodule
