Altair-Raphael/SomLetrando/Versão Final/hardware/src/datapath/contador_163.v

//------------------------------------------------------------------
// Arquivo   : contador_163.v
// Projeto   : Experiencia 4 - Desenvolvimento de Projeto de
//             Circuitos Digitais com FPGA
//------------------------------------------------------------------
// Descricao : Contador binario de 4 bits, modulo 16
//             similar ao componente 74163
//
// baseado no componente Vrcntr4u.v do livro Digital Design Principles 
// and Practices, Fifth Edition, by John F. Wakerly              
//------------------------------------------------------------------
// Revisoes  :
//     Data        Versao  Autor             Descricao
//     14/12/2023  1.0     Edson Midorikawa  versao inicial
//------------------------------------------------------------------
//
module contador_163 #(parameter N=4) ( clock, clr, ld, ent, enp, D, Q, rco );
    input clock, clr, ld, ent, enp;
    input [N-1:0] D;
    output reg [N-1:0] Q;
    output reg rco;

    always @ (posedge clock)
        if (~clr)               Q <= {N{1'b0}};
        else if (~ld)           Q <= D;
        else if (ent && enp)    Q <= Q + 1'b1;
        else                    Q <= Q;
 
    always @ (Q or ent)
        if (ent && (Q == {N{1'b1}}))   rco = 1;
        else                       rco = 0;
endmodule
