Altair-Raphael/SomLetrando/Versão Final/hardware/src/datapath/comparador_85.v

 /* -----------------------------------------------------------------
 *  Arquivo   : comparador_85.v
 *  Projeto   : EExperiencia 4 - Desenvolvimento de Projeto de
 *                              Circuitos Digitais com FPGA
 * -----------------------------------------------------------------
 *  Descricao : comparador de magnitude de 4 bits 
 *             similar ao CI 7485
 *             baseado em descricao comportamental disponivel em	
 * https://web.eecs.umich.edu/~jhayes/iscas.restore/74L85b.v
 * -----------------------------------------------------------------
 * Revisoes  :
 *     Data        Versao  Autor             Descricao
 *     21/12/2023  1.0     Edson Midorikawa  criacao
 * -----------------------------------------------------------------
 */

module comparador_85 (ALBi, AGBi, AEBi, A, B, ALBo, AGBo, AEBo);

    input[7:0] A, B;
    input      ALBi, AGBi, AEBi;
    output     ALBo, AGBo, AEBo;
    wire [8:0] CSL, CSG;

    assign CSL  = ~A + B + ALBi;
    assign ALBo = ~CSL[8];
    assign CSG  = A + ~B + AGBi;
    assign AGBo = ~CSG[8]; 
    assign AEBo = ((A === B) && AEBi); 

endmodule /* comparador_85 */
