Altair-Raphael/SomLetrando/semana2/hardware/src/datapath/tx_serial_8N1_fd.v

/* -------------------------------------------------------------
 * Arquivo   : tx_serial_7N2_fd.v
 *--------------------------------------------------------------
 * Descricao : fluxo de dados do circuito base de transmissao 
 *             serial assincrona (7N2) 
 *             ==> contem deslocador com 11 bits e contador
 *                 modulo 12
 * 
 *--------------------------------------------------------------
 * Revisoes  :
 *     Data        Versao  Autor             Descricao
 *     30/08/2025  1.0     Edson Midorikawa  criacao
 *--------------------------------------------------------------
 */
 
 module tx_serial_8N1_fd (
    input        clock        ,
    input        reset        ,
    input        zera         ,
    input        conta        ,
    input        carrega      ,
    input        desloca      ,
    input  [7:0] dados_ascii  ,
    output       saida_serial ,
    output       fim
);

    wire [9:0] s_dados;
    wire [9:0] s_saida;

    // composicao dos dados seriais
    assign s_dados[0]   = 1'b0;             // start bit
    assign s_dados[8:1] = dados_ascii[7:0]; // dado
    assign s_dados[9]  = 1'b1;             // stop bit
  
    // Instanciação do deslocador_n
    deslocador_n #(
        .N(10) 
    ) U1 (
        .clock         (clock  ),
        .reset         (reset  ),
        .carrega       (carrega),
        .desloca       (desloca),
        .entrada_serial(1'b1   ), 
        .dados         (s_dados),
        .saida         (s_saida)
    );
    
    // Instanciação do contador_m
    contador_m #(
        .M(10),
        .N(4)
    ) U2 (
        .clock   (clock),
        .zera_as (1'b0 ),
        .zera_s  (zera ),
        .conta   (conta),
        .Q       (     ), // porta Q em aberto (desconectada)
        .fim     (fim  ),
        .meio    (     )  // porta meio em aberto (desconectada)
    );
    
    // Saida serial do transmissor
    assign saida_serial = s_saida[0];
  
endmodule
