Altair-Raphael/SomLetrando/(commit log)

2026-03-20 Estruturação inicial do projeto SomLetrando, organização de diretórios e separação datapath/control
2026-04-03 🎨 Separating project in weeks
2026-04-03 🙈 Turning .gitignore global
2026-04-03 📝 Pre-lab plan
2026-04-03 📝 Hardware archive: Quartus
2026-04-03 ✅ Testbenches for top-level
2026-04-03 🚚 Moving archives to control folder
2026-04-03 🚧 Basis archives for logic project
2026-04-03 🙈 Attempts to upload too large videos
2026-04-03 🔥 New .gitignore files
2026-04-03 🙈 New .gitignore files
2026-04-03 📝 Researching for project
2026-04-20 📝 Lab validation report
2026-04-20 🚧Hardware archive: Quartus
2026-04-20 💩 Initial code for Serial Communication
2026-04-27 📝 Week 2 datapath archives
2026-04-27 📝 Week 2 control archives
2026-04-27 📝 Base verilog archives
2026-04-27 📝 Week 3 control archives
2026-04-27 ✨ feature: debounce
2026-04-27 🐛 Fix: serial communication
    [tx_rotina_auxiliar.v]
2026-04-27 ✨ Initial look up table
2026-04-27 ➖ Feat: removing analog dependency
2026-04-27 📝 Week 4 datapath archives
2026-04-27 📝 Week 4 control archives
2026-04-27 💄🚧 Initial prototype for interface
2026-04-28 📝 Final verilog datapath archives
2026-04-28 🚸 User guide
2026-04-28 🚸 SomLetrando pitch presentation
2026-04-28 📝 Final verilog control archives
2026-04-28 🚀 Final quartus project
2026-04-28 ⚡️ Final graphic interface
2026-04-28 💬 Updating README
